Worki56/Projekt_SM/Dokumentacja.pdf

Politechnika Poznańska
Wydział Automatyki, Robotyki i Elektrotechniki Systemy mikroprocesorowe

Projekt

Sterowanie obrotami silnika za pomocą

sterownika PID

Autor:

Wiktor Rosiński
144576

Paweł Kwiatkowski
139654

## 1 Opis działania

Projekt zakłada sterowanie obrotami silnika po przez sterownik PID realizowanego za pomocą modułu NUCLEO F746ZG.
Wartość prędkości zadanej ustawiamy za pomocą enkodera lub za pośrednictwem programu wykonanego w języku Phyton. Następnie moduł nukleo nastawia sterowanie na silnik by kręcił się z zadaną prędkością.
Pomiar prędkości silnika realizowany jest po przez pomiar wzrostów rezystancji na fotorezystorze spowodowany przysłonięciem diody umieszczonej za silnikiem co jeden obrót. Dodaliśmy również funkcjonalność opserwacji pracy silnika na wykresie w czasie rzeczywistym w programie w języku Phyton. Silnik wyposażony jest w śmigło, które skonstrułowane jest tak by tylko raz na obrót było w stanie zasłonić diodę. Jest to nasza pętla ujemnego sprzężenia zwrotnego.

## 2 Schemato gólny projektu

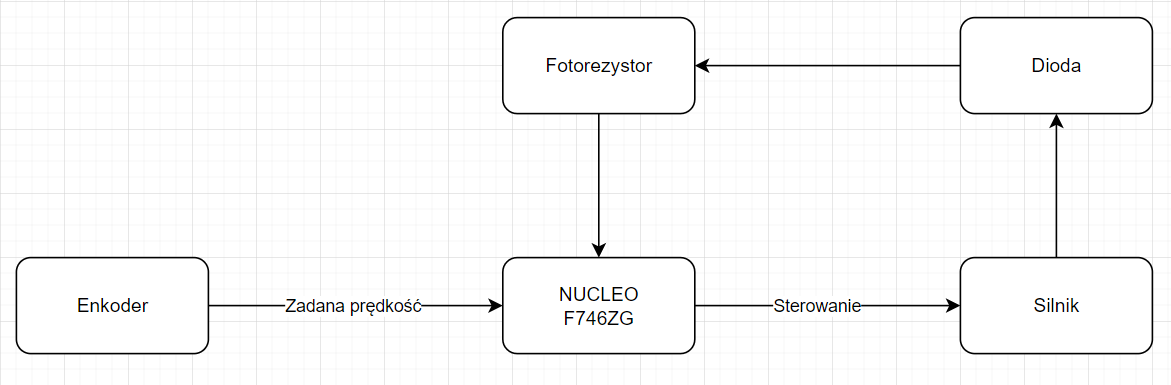
[picture p1: figure]

Schemat przedstawia logike układu i oddziałowywywanie poszczególnych komponentów na siebie.

## 3 Schemat elektryczny

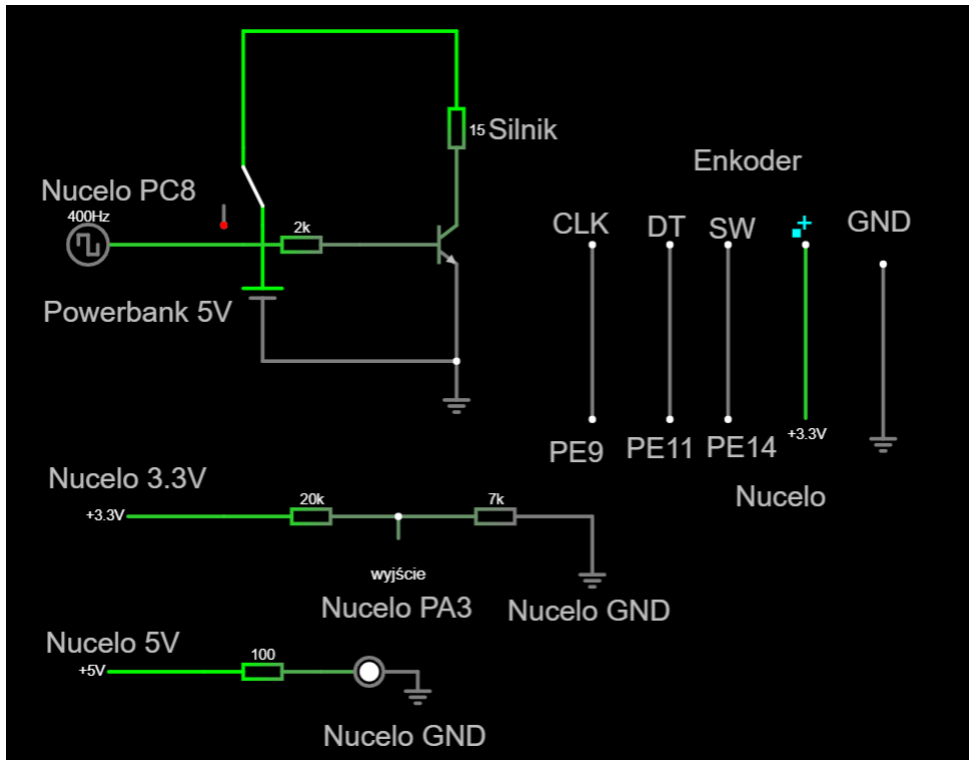
[picture p2: figure]

Dodatkowo można pobrać plik txt z naszego githaba (https://github.com/Worki56/Projekt_SM) i sprawdzić działanie układu w internetowym progeramie falstad. (https://www.falstad.com/circuit/circuitjs.html)

## 4 Użyte części w projekcie

### 4.1 NUCLEO F746 ZG

Modół Nucleo jest sterownikiem jak i komunikatorem pomiędzy wszystkimi częściami naszego układu. Za jego pośrednictwem będziemy odbierać sygnały z poszczególnych części jak i nadawać sygnały sterujące. Służyć też będzie nam jako źródło zasilania. W poniższej tabeli zostały wypisane wykorzystywane piny i ich zastosowanie.

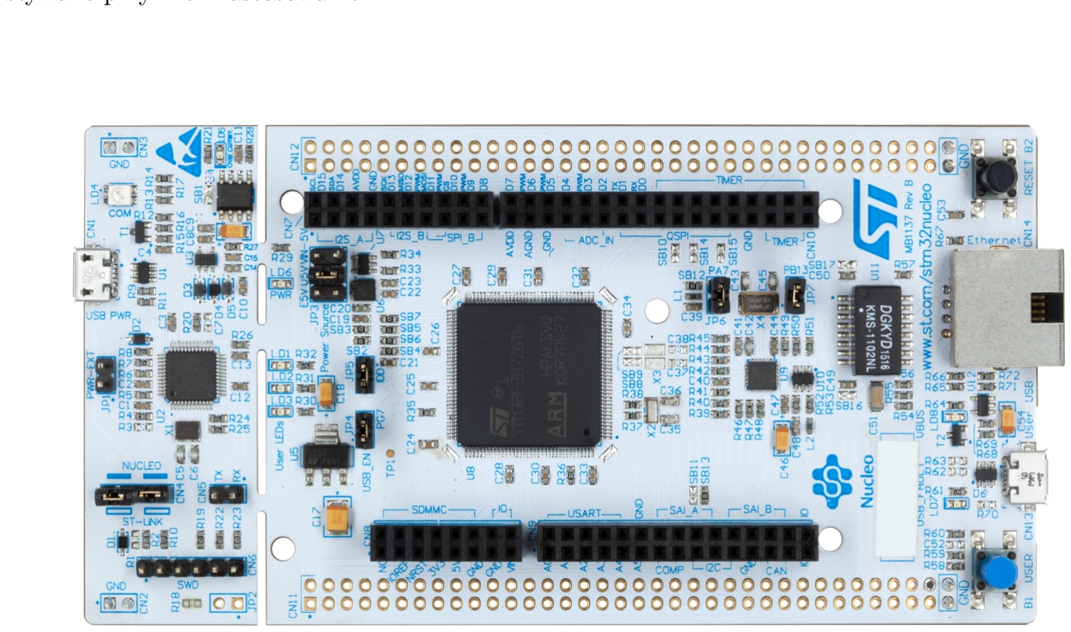
[picture p3: figure]

Nazwa i numer pinu | zastosowanie
PC8 | Podajemy napięcie na bazę tranzystora
3V | zasilanie enkodera i fotorezystora
5V | zasila diodę
GND | Używane do urziemienia oraz diody
PA3 | Sczytuje sygnał z fotorezystora
GND | Uziemienie silnika, tranzystora
PE9 | Opsługuje wejście CLK enkodera
PE11 | Opsługuje wejście DT enkodera
PE14 | Opsługuje wejście SW enkodrea

### 4.2 Silnik

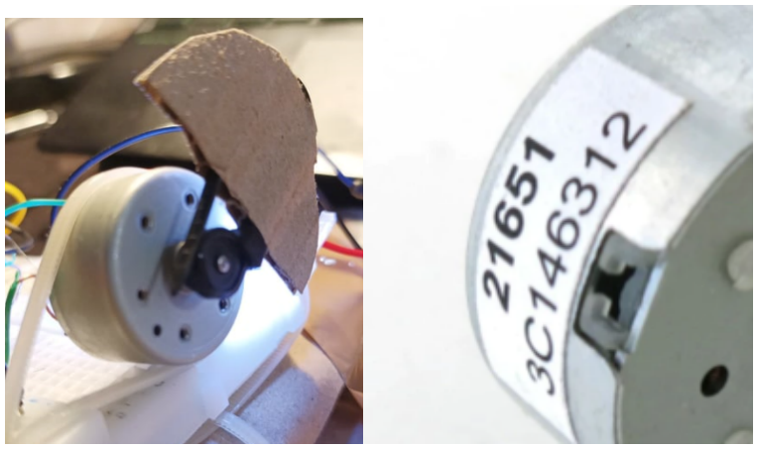
[picture p4: figure]

Obiekt regulacji.
Silnik został wymontowany z odtwarzacza CD jego numer seryjny to: 3C146312.
Staraliśmy się znaleźć dokumentacje do niego lub podobny model i jedyne co znaleźliśmy to silnik o numerze seryjnym: rc300-ft-08800. Próbowaliśmy na podstawie dołączonych do niego danych zamodelować nasz silnik jednak nie dawało to współmiernych wyników. Dlatego samodzielnie staraliśmy sie wyznaczyć jego wartości i model.
Wartość rezystancji silnika to 15 Ω w stanie spoczynku.

### 4.3 Moduł zasilający do płytek stykowych MB102

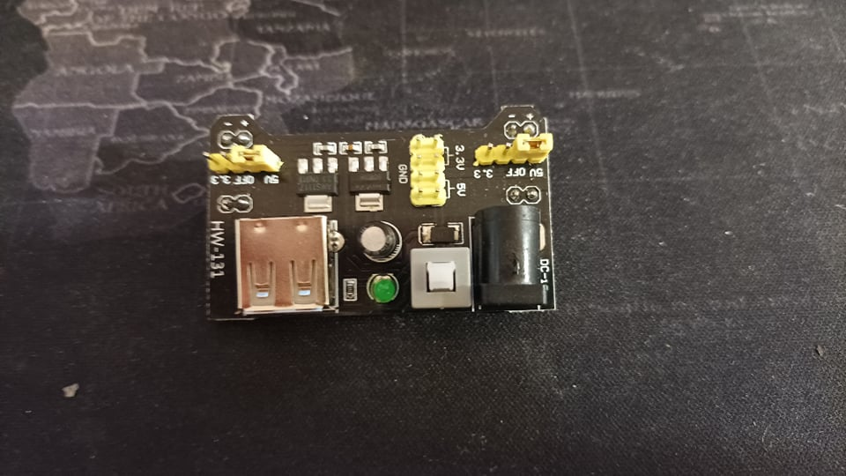
[picture p5: figure]

Początkowo silnik zasilany był z baterji 9V jednak z powodu użytkowania z czasem bateria się rozładowywała zdecydowaliśmy się na zamiane bateri na moduł zasilający. Jest on bardziej efektywny i ekonomiczny w przypadku sterowania i ciągłej pracy z układem.

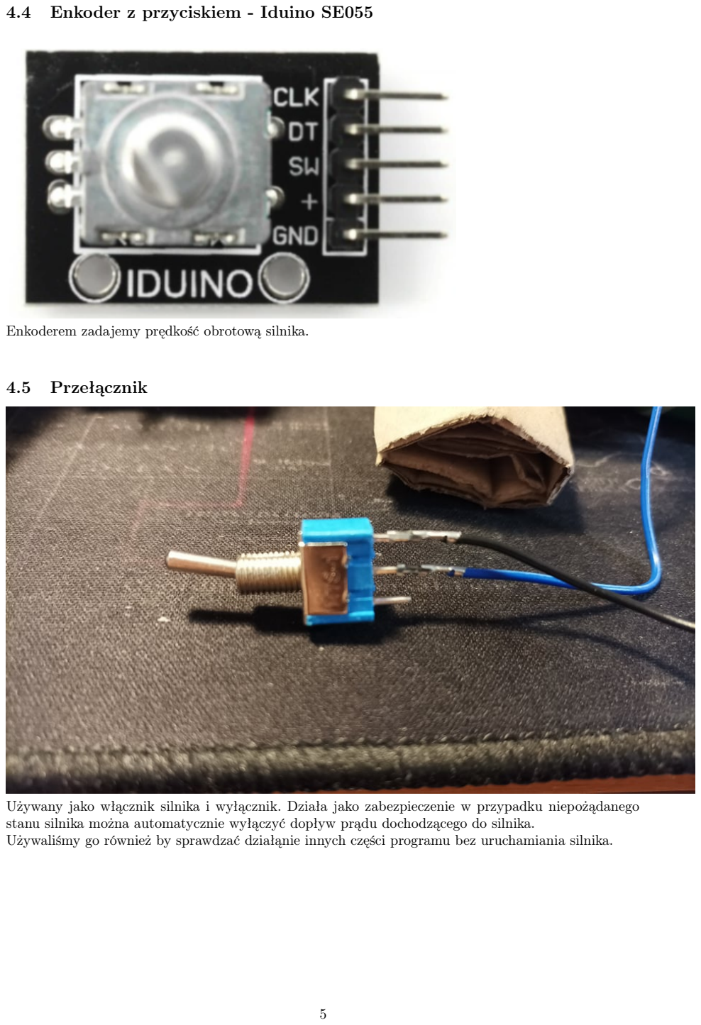
[picture p6: page 6]

### 4.4 Enkoder z przyciskiem - Iduino SE055

Enkoderem zadajemy prędkość obrotową silnika.

### 4.5 Przełącznik

Używany jako włącznik silnika i wyłącznik. Działa jako zabezpieczenie w przypadku niepożądanego stanu silnika można automatycznie wyłączyć dopływ prądu dochodzącego do silnika.
Używaliśmy go również by sprawdzać działąnie innych części programu bez uruchamiania silnika.

### 4.6 Tranzystor S9013

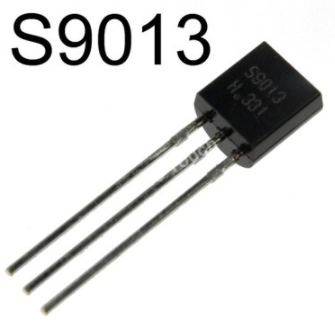
[picture p7: figure]

Używany do sterowania silnikiem.

### 4.7 Fotorezystor GL5528

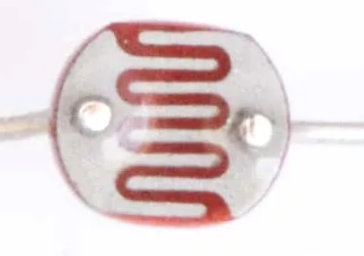
[picture p8: figure]

Przy jego pomocy mierzymy zadaną prędkość obrotów. Konkretniej w programie szczytujemy skoki rezystancji w chwili gdy silnik zasłoni diodę śmigłem.
Rozważaiśmy również użycie miernika światła jednak układ działał przez to za wolno z tego względu zdecydowaliśmy się na dzielnik napięcia z fotorezystorem.
Dodatkowo by zredukować szum pomiarowy skupiliśmy pomiar jasności za pomocą przesłony. Zakres rezystancji możliwej do uzyskania fotorezystorze to od 10 000 Ω do 20 000 Ω

### 4.8 Rezystory oraz Diody

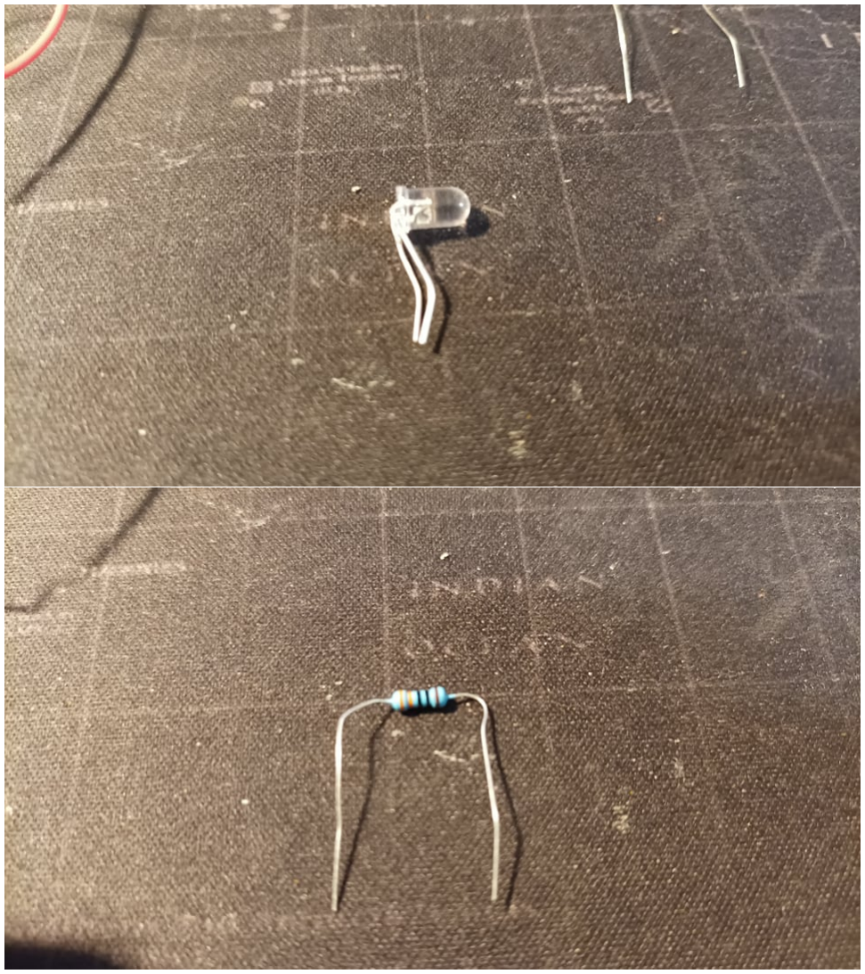
[picture p9: figure]

Dioda używana do pomiaru prędkości. Rezystory ustawiają napięcie na
bazie tranzystorze (2 000 Ω),
dzielnika napięć przy fotorezystorze (7 000 Ω) oraz prąd na diodzie(108 Ω).

### 4.9 Połączony układ

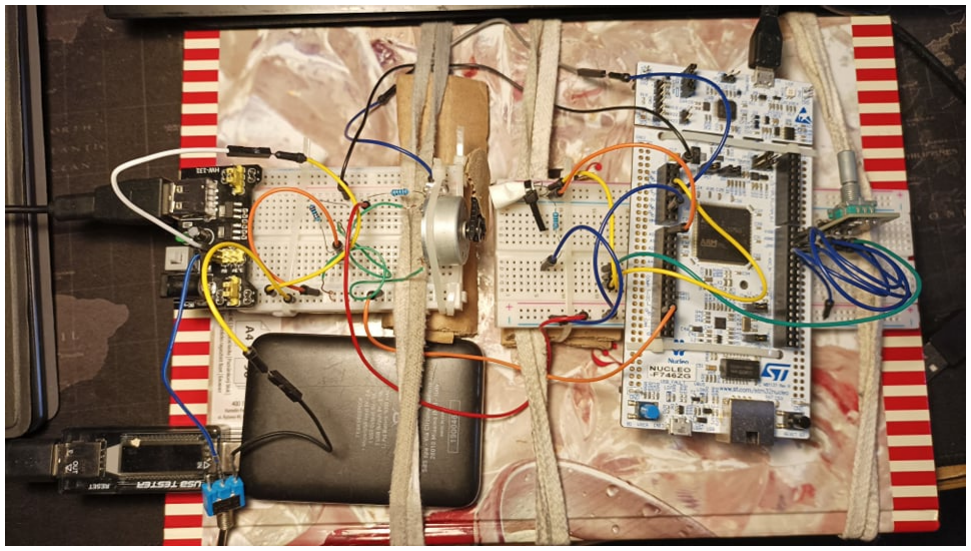
[picture p10: figure]

Omówienie układu zprezentacją jego działania można obejrzeć w niniejszym linku. (https://www.youtube.com/watch?v=o5V21cgO-BU)

## 5 Program

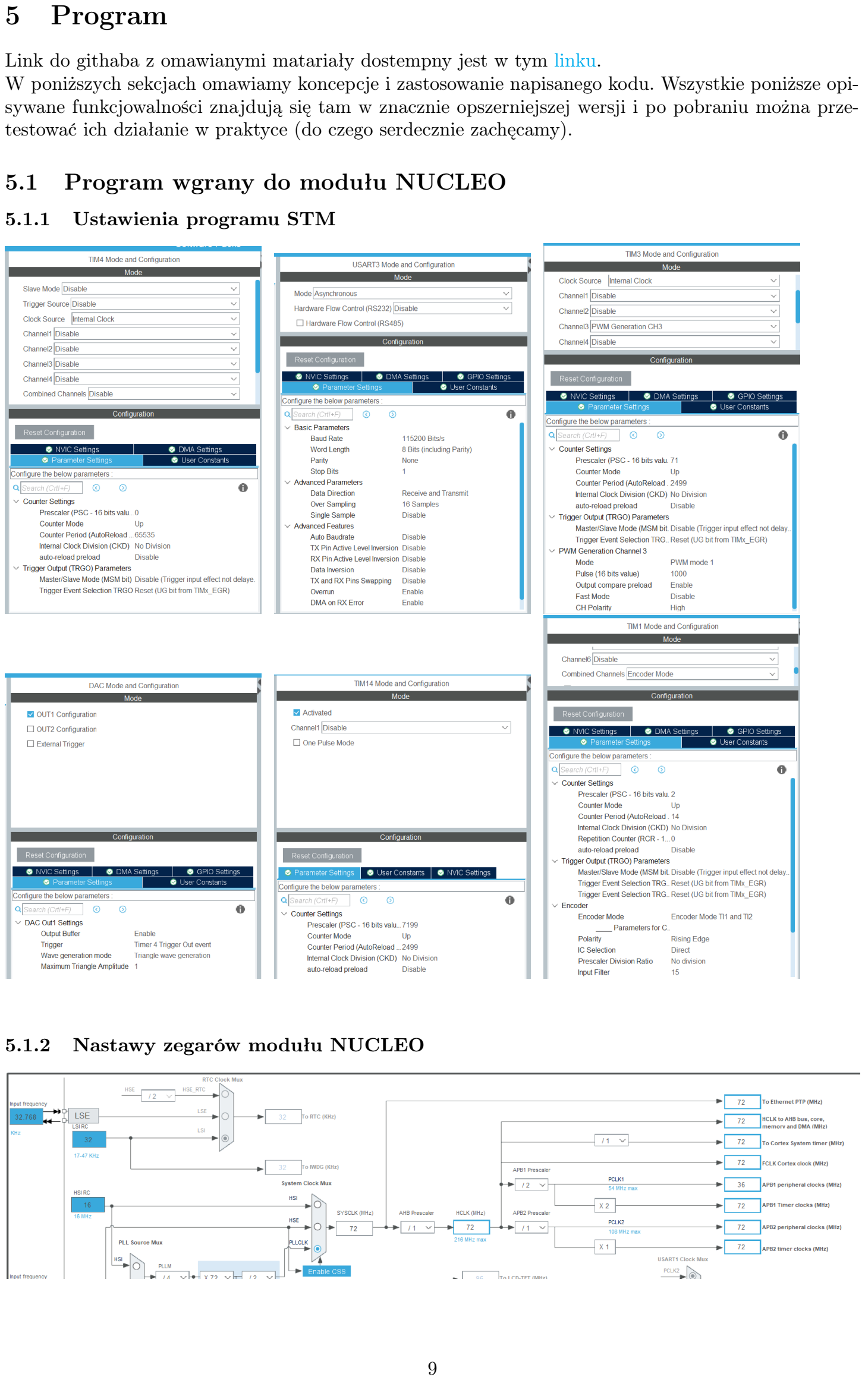
[picture p11: page 10]

Link do githaba z omawianymi matariały dostempny jest w tym linku. (https://github.com/Worki56/Projekt_SM)
W poniższych sekcjach omawiamy koncepcje i zastosowanie napisanego kodu. Wszystkie poniższe opisywane funkcjowalności znajdują się tam w znacznie opszerniejszej wersji i po pobraniu można przetestować ich działanie w praktyce (do czego serdecznie zachęcamy).

### 5.1 Program wgrany do modułu NUCLEO

### 5.1.1 Ustawienia programu STM

### 5.1.2 Nastawy zegarów modułu NUCLEO

### 5.1.3 Funkcje

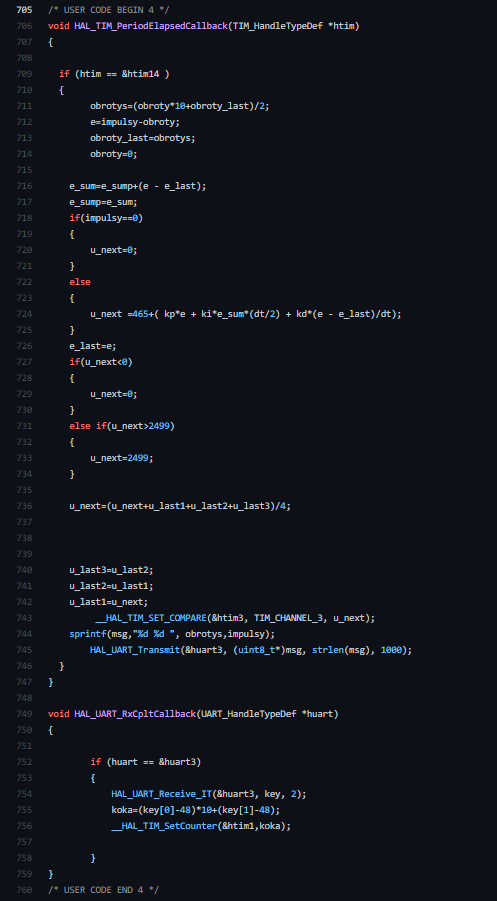
[picture p12: figure]

Implementacja sterowania PID zaimplementowana została w funkcji void HAL TIM PeriodElapsedCallback(TIM HandleTypeDef *htim). Jak widać zaimplementowany jest tu klasyczny układ regulacji na podstawie podstawowego równania opisującego regupator PID z filtrem FIR by uzyskać dokładniejsze sterowanie.

Funkcja void HAL UART RxCpltCallback(UART HandleTypeDef *huart) służy do odbierania wartości zadanej z programu Phyton

### 5.1.4 Sprawdzenie czy wystąpił obrót

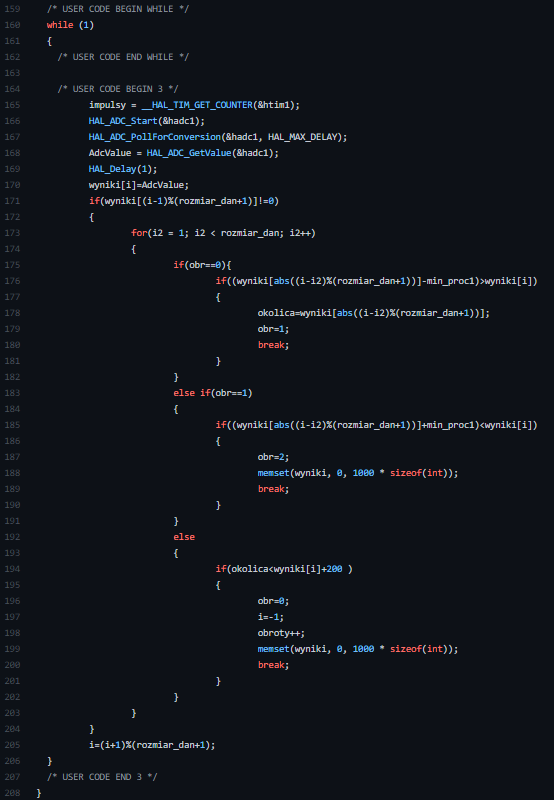
[picture p13: figure]

W whylu zaimplementowaliśmy zlicznnie obrotów silnika na podstawie skoków wartości rezystancji fotorezystora. Dodatkowo dodaliśmy warunki by program drobnych spadków jasności wywołanych ruchem otoczenia nie wpływał na zliczanie obrotów.

### 5.2 Program wyświetlający prędkość obrotową silnika z pomiarów

Program po uruchomieniu sczytuje prędkość obrotową silnika z modułu NUCLEO i wizualizuje dane w postaci wykresu. Wykres na osi y ilość obrotów zaś w osi x czas. Po uruchomieniu programu widoczne są na wykresie oscylacje. Wynikają one z szumu pomiarowego. Jednak nie utrudniają one oceny poprawnego działania układu regulacji.
Za pośrednictwem programu możemy równiesz nastawić wartość zadaną.

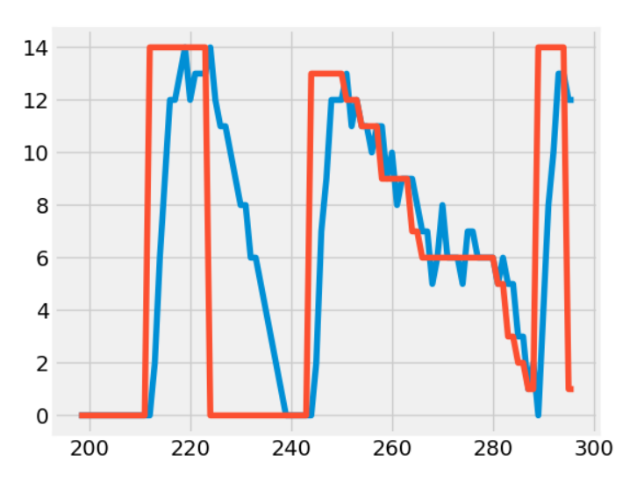
[picture p14: figure]

## 6 Model w Regulatora

Przugotowaliśmy równiesz prosty model działania naszego układu regulacji. Został on wykonany w programie Simulink. Można go pobrać z załączonego githaba i sprawdzić za jego pośrednictwem czy działanie układu żeczywistego działa zgodnie z założeniami.

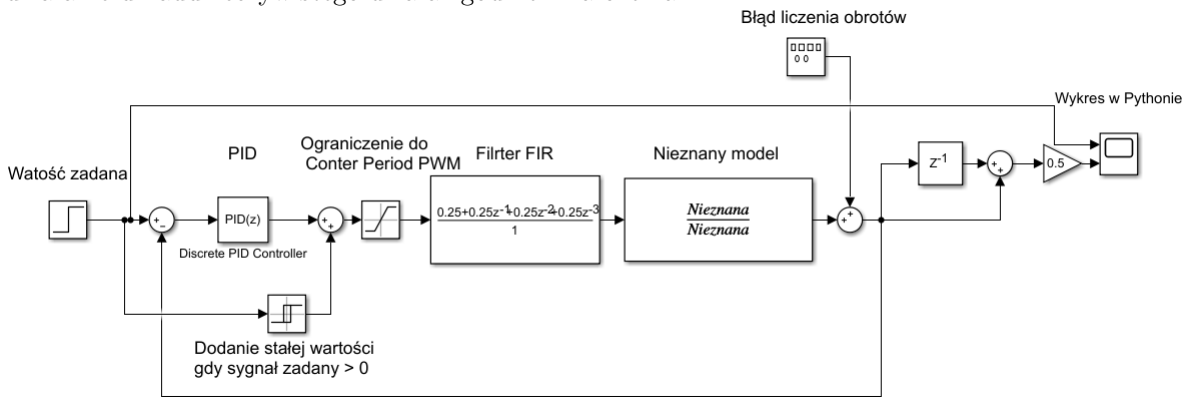
[picture p15: figure]
