Worki56/Projekt_SM/Core/Src/main.c

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
/* Includes ------------------------------------------------------------------*/
#include "main.h"

/* USER CODE BEGIN Includes */
#include <stdio.h>
#include <string.h>
/* USER CODE END Includes */

ADC_HandleTypeDef hadc1;

DAC_HandleTypeDef hdac;

TIM_HandleTypeDef htim1;
TIM_HandleTypeDef htim3;
TIM_HandleTypeDef htim4;
TIM_HandleTypeDef htim14;

UART_HandleTypeDef huart3;

PCD_HandleTypeDef hpcd_USB_OTG_FS;

void SystemClock_Config(void);
static void MX_GPIO_Init(void);
static void MX_USART3_UART_Init(void);
static void MX_USB_OTG_FS_PCD_Init(void);
static void MX_TIM1_Init(void);
static void MX_TIM3_Init(void);
static void MX_DAC_Init(void);
static void MX_ADC1_Init(void);
static void MX_TIM14_Init(void);
static void MX_TIM4_Init(void);
/* USER CODE BEGIN PFP */
int impulsy;
char msg [50];
int i=0;
int i2=0;
int i3=0;
float AdcValue;
int rozmiar_dan=1000;
int wyniki [1000];
int obr=0;
int okolica;
float min_proc1=400;
int obroty;
int obrotys=0;
int koka;
uint8_t key[2];
float kp=1000;
float ki=750;
float kd=0;
float e;
float e_sum;
float e_sump;
float e_last;
float u;
float u_next;
float u_last1;
float u_last2;
float u_last3;
float dt=0.25;
float obroty_last;

/* USER CODE END PFP */

/**
  * @brief  The application entry point.
  * @retval int
  */
int main(void)
{
  /* MCU Configuration--------------------------------------------------------*/

  /* Reset of all peripherals, Initializes the Flash interface and the Systick. */
  HAL_Init();

  /* Configure the system clock */
  SystemClock_Config();

  /* Initialize all configured peripherals */
  MX_GPIO_Init();
  MX_USART3_UART_Init();
  MX_USB_OTG_FS_PCD_Init();
  MX_TIM1_Init();
  MX_TIM3_Init();
  MX_DAC_Init();
  MX_ADC1_Init();
  MX_TIM14_Init();
  MX_TIM4_Init();
  /* USER CODE BEGIN 2 */
  /* inicjacja potrzebnych elementów */
  HAL_TIM_Encoder_Start(&htim1, TIM_CHANNEL_ALL);
  HAL_TIM_PWM_Start (&htim3, TIM_CHANNEL_3);
  HAL_TIM_Base_Start(&htim4);
  HAL_DAC_Start(&hdac, DAC_CHANNEL_1);
  HAL_TIM_Base_Start_IT(&htim14);
  HAL_UART_Receive_IT(&huart3, key, 2);


  /* USER CODE END 2 */

  /* Infinite loop */
  /* USER CODE BEGIN WHILE */
  while (1)
  {
    /* USER CODE END WHILE */

    /* USER CODE BEGIN 3 */
      /* sczytanie wartości z enkodera*/
	  impulsy = __HAL_TIM_GET_COUNTER(&htim1);
	  /* szczytanie wartości z dzielnika napięcia*/
	  HAL_ADC_Start(&hadc1);
	  HAL_ADC_PollForConversion(&hadc1, HAL_MAX_DELAY);
	  AdcValue = HAL_ADC_GetValue(&hadc1);
	  HAL_Delay(1);
	  wyniki[i]=AdcValue;
	  /* zobserwowanie obrotu*/
	  if(wyniki[(i-1)%(rozmiar_dan+1)]!=0)
	  {
		  for(i2 = 1; i2 < rozmiar_dan; i2++)
		  {
			  /* zobserwowanie spadku*/
			  if(obr==0){
				  if((wyniki[abs((i-i2)%(rozmiar_dan+1))]-min_proc1)>wyniki[i])
				  {
					  okolica=wyniki[abs((i-i2)%(rozmiar_dan+1))];
					  obr=1;
					  break;
				  }
			  }
			  /* zobserwowanie wzrostu*/
			  else if(obr==1)
			  {
				  if((wyniki[abs((i-i2)%(rozmiar_dan+1))]+min_proc1)<wyniki[i])
				  {
					  obr=2;
					  memset(wyniki, 0, 1000 * sizeof(int));
					  break;
				  }
			  }
			  /* zobserwowanie osiągnięcia stanu wysokiego*/
			  else
			  {
				  if(okolica<wyniki[i]+200 )
				  {
					  obr=0;
					  i=-1;
					  obroty++;
					  memset(wyniki, 0, 1000 * sizeof(int));
					  break;
				  }
			  }
		  }
	  }
	  i=(i+1)%(rozmiar_dan+1);
  }
  /* USER CODE END 3 */
}

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
/* USER CODE BEGIN 4 */
/* wykonywanie z częstotliwościa 4Hz*/
void HAL_TIM_PeriodElapsedCallback(TIM_HandleTypeDef *htim)
{

  if (htim == &htim14 )
  {
	 /* Średnia z 2 ostatnich wyników obrotów*/
	obrotys=(obroty*10+obroty_last)/2;
	/* PID*/
	e=impulsy-obroty;
	obroty_last=obrotys;
	obroty=0;

    e_sum=e_sump+(e - e_last);
    e_sump=e_sum;
    /*Dodanie wartości stałej potrzebnej aby pokonać bezwładność*/
    if(impulsy==0)
    {
    	u_next=0;
    }
    else
    {
    	u_next =465+( kp*e + ki*e_sum*(dt/2) + kd*(e - e_last)/dt);
    }
    e_last=e;
    /*Saturacja */
    if(u_next<0)
    {
    	u_next=0;
    }
    else if(u_next>2499)
    {
    	u_next=2499;
    }
    /* Filtr FIR*/
    u_next=(u_next+u_last1+u_last2+u_last3)/4;
    u_last3=u_last2;
    u_last2=u_last1;
    u_last1=u_next;
    /* Zadanie wypełnienia PWM*/
	 __HAL_TIM_SET_COMPARE(&htim3, TIM_CHANNEL_3, u_next);
	 /*Wysłanie informacji przez USART */
    sprintf(msg,"%d %d ", obrotys,impulsy);
	HAL_UART_Transmit(&huart3, (uint8_t*)msg, strlen(msg), 1000);
  }
}
/*Otrzymanie wartości zadanej przez program "komunikacja"*/
void HAL_UART_RxCpltCallback(UART_HandleTypeDef *huart)
{

	if (huart == &huart3)
	{
		/*konwersja*/
	    HAL_UART_Receive_IT(&huart3, key, 2);
	    koka=(key[0]-48)*10+(key[1]-48);
	    __HAL_TIM_SetCounter(&htim1,koka);

	}
}
/* USER CODE END 4 */
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
