Worki56/Projekt_SM/Komunikacja.py

import serial
import time
import numpy as np
from itertools import count
from threading import Thread
import matplotlib.pyplot as plt
from matplotlib.animation import FuncAnimation
#Połączenie z portem COM
stm32 = serial.Serial('COM3', 115200, timeout=0.01)
x=50
esa='40'
n=0
plt.figure()
plt.style.use('fivethirtyeight')
plt.ion()
plt.show()

wyniki=[]
wyniki1=[]
wyniki2=[]
ile=count()
spaw=0
wyraz_tyczas=""
#Funkcja sprawdzająca czy użytkownik wprowadził wartość
def myfunc():
    fdf=input("Podaj ilość obrotów na 0.25s (2 cyfry max 14)\n")
    stm32.write(fdf.encode())
    global n
    n=0
    return

while True:
    #otrzymanie danych
    data = stm32.readline()
    if data:
        data = data.decode()
        #wykrycie interesujących danych
        for i in range(0, len(data)):

            if data[i] == " " or data[i] == "\n":
                if spaw==0:
                    wyniki.append(int(wyraz_tyczas)/10)
                    spaw=1
                elif spaw==1:
                    wyniki1.append(int(wyraz_tyczas))
                    spaw=0
                wyraz_tyczas=''
            else:
                wyraz_tyczas = wyraz_tyczas + data[i]
        wyniki2.append(next(ile))
        #aktualizacja danych na wykresie
        plt.cla()
        plt.plot(wyniki2[-100:-1],wyniki[-100:-1])
        plt.plot(wyniki2[-100:-1],wyniki1[-100:-1])
        plt.legend(['Ilość obrotów', 'Wartość zadana'],loc='upper left')
        plt.title("Wykres otrzymanych wartości co 0.25s ")
        plt.xlabel('Nr próbki ')
        plt.pause(0.01)


    if n==0:
        n = 1
        t = Thread(target=myfunc)
        t.start()
