Worki56/Projekt_SM/(commit log)

2022-01-20 V1
    Pierwsza próba przesłania, początkowej wersji zawierająca komunikacje z elementami takimi jak sterowanie pwm oraz wynikiem otrzymanym z fotorezystora.
2022-01-23 V4
    Dodanie działającego PID
2022-01-26 V5
    Ustalenie najlepszego PID które znaleźliśmy
